mpinese/adc/bom.xlsx

Assembly | Designator | Value | Footprint | DigiKey | Quantity
Signal | C1 | 10u | Capacitor_SMD:C_1206_3216Metric | 1276-6767-1-ND | 1
Signal | C2 | 2.2u | Capacitor_SMD:C_0805_2012Metric | 1276-6655-1-ND | 1
Signal | C3, C4 | 10u | Capacitor_Tantalum_SMD:CP_EIA-3528-21_Kemet-B | 718-1926-1-ND | 2
Signal | C5, C6 | 10u | Capacitor_SMD:C_1206_3216Metric | 1276-2876-1-ND | 2
Signal | C7-C9 | 0.47u | Capacitor_SMD:C_0805_2012Metric | 1276-1039-1-ND | 3
Signal | C10, C11 | 22u | project_footprints:C_1210_3225Metric_Split | 1276-3392-1-ND | 2
Signal | C12 | 10u | project_footprints:C_1206_3216Metric_Split | 1276-3107-1-ND | 1
Signal | D1-D4 | CUS520,H3F | Diode_SMD:D_SOD-323 | CUS520H3FCT-ND | 4
Signal | R2, R3 | 330 | Resistor_SMD:R_0603_1608Metric | RG16P330BCT-ND | 2
Signal | R1, R4, R5 | 0.5 | Resistor_SMD:R_0805_2012Metric | RL12S.50FCT-ND | 3
Signal | R6, R7 | 150k | Resistor_SMD:R_0603_1608Metric | RG16P150KBCT-ND | 2
Signal | R8 | 40.2k | Resistor_SMD:R_0603_1608Metric | RG16P40.2KBCT-ND | 1
Signal | U1 | LDL1117S50R | Package_TO_SOT_SMD:SOT-223-3_TabPin2 | 497-17240-1-ND | 1
Signal | U2, U4 | LT3042xMSE | Package_SO:MSOP-10-1EP_3x3mm_P0.5mm_EP1.68x1.88mm_ThermalVias | LT3042EMSE#PBF-ND | 2
Signal | U3 | LT3093xMSE | Package_SO:MSOP-12-1EP_3x4mm_P0.65mm_EP1.65x2.85mm_ThermalVias | LT3093EMSE#PBF-ND | 1
Transformer | C1, C4 | 2200u | Capacitor_THT:CP_Radial_D10.0mm_P5.00mm | 565-3869-ND | 2
Transformer | C2, C3, C5, C6 | 2200u | Capacitor_THT:CP_Radial_D12.5mm_P5.00mm | 565-3923-ND | 4
Transformer | C7, C8 | 10u | Capacitor_THT:CP_Radial_D5.0mm_P2.00mm | 565-4993-1-ND | 2
Transformer | R1 | 10k | Resistor_THT:R_Axial_DIN0207_L6.3mm_D2.5mm_P7.62mm_Horizontal | PPC10.0KYCT-ND | 1
Transformer | R2, R3 | 3.9k | Resistor_THT:R_Axial_DIN0207_L6.3mm_D2.5mm_P7.62mm_Horizontal | 56-SFR25H0003901FR500CT-ND | 2
Transformer | R4, R5 | 330 | Resistor_THT:R_Axial_DIN0207_L6.3mm_D2.5mm_P7.62mm_Horizontal | 56-SFR25H0003300FR500CT-ND | 2
Transformer | T1 | 14A-30-515 | XFMR_14A-30-515 | 595-1828-ND | 1
Transformer | D1, D2 | D_Bridge_+-AA | Diode_THT:Diode_Bridge_DIP-4_W7.62mm_P5.08mm | DF02MDI-ND | 2
Transformer | U1 | LM317_TO-220 | Package_TO_SOT_THT:TO-220-3_Vertical | 497-19621-ND | 1
Transformer | U2 | LM337_TO220 | Package_TO_SOT_THT:TO-220-3_Vertical | LM337TGOS-ND | 1
Transformer | HS1, HS2 | Heatsink for U1,U2 |  | HS104-1-ND | 2
Case | F1, F2 | 200 mA slow blow 5x20 mm |  |  | 2
Case | J2, J3 | Conn_Coaxial |  | ARFX1905-ND | 2
Case | J4 | IEC320-C14 Power entry module |  | 1144-1003-ND | 1
Case | K1 | Knob |  | 1722-1313-ND | 1
Case | M1 | Board mounts for PCM4222EVM |  | RPC1449-ND | 4
