mpinese/adc/kicad/3d_models/CUI_DEVICES_UJ2-BH-1-TH.step

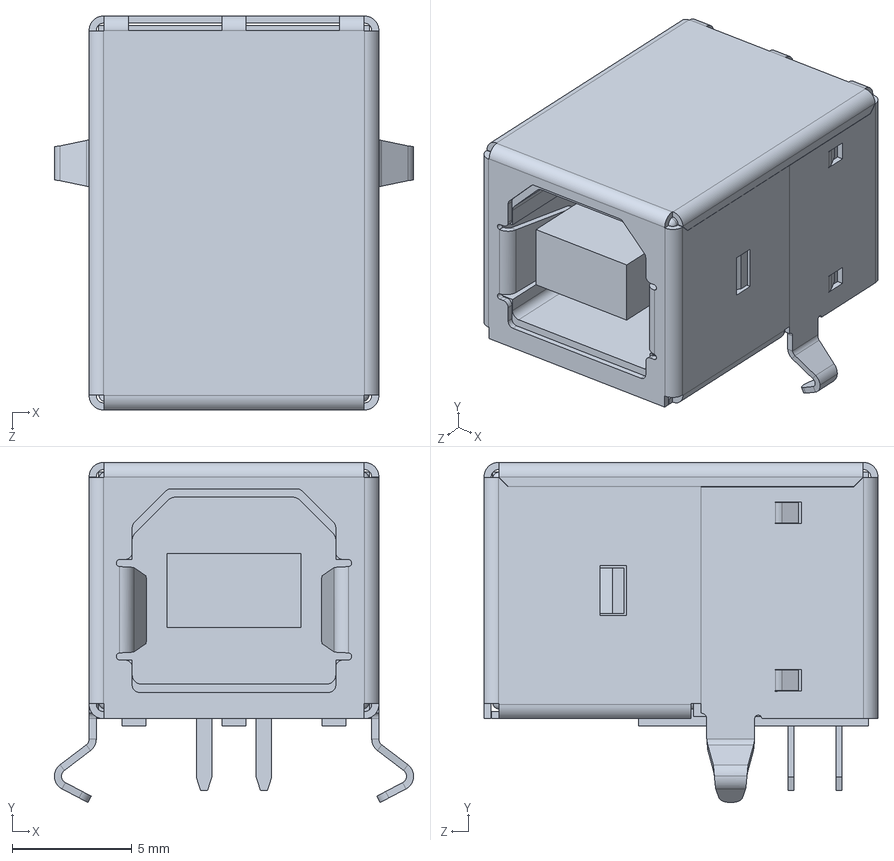
[picture p1: CAD file, 2020-09-04]
kicad/3d_models/CUI_DEVICES_UJ2-BH-1-TH.step
15.0 x 14.2 x 16.5 mm
