mpinese/adc/kicad/3d_models/14A-30-515--3DModel-STEP-1.STEP

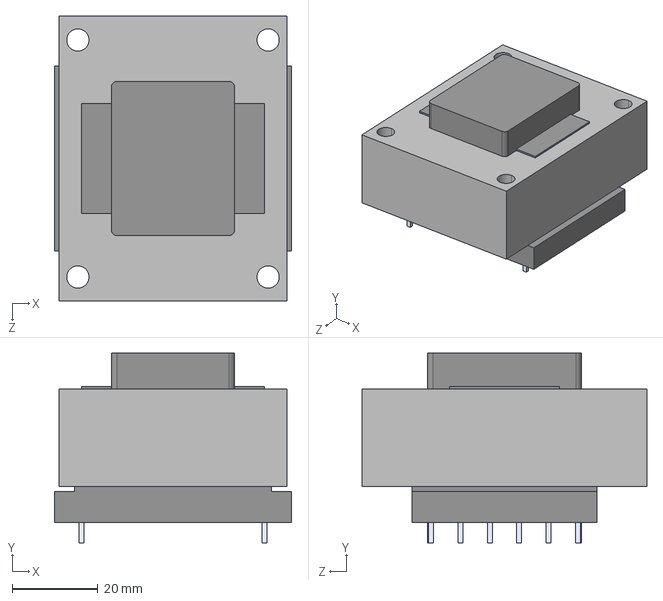
[picture p2: CAD file, 2020-09-04]
kicad/3d_models/14A-30-515--3DModel-STEP-1.STEP
55.4 x 44.4 x 66.5 mm
