mpinese/adc/kicad/usb_bridge/test_i2s_gen_cpld/test_i2s_gen.kicad_pcb

## KiCad design kicad/usb_bridge/test_i2s_gen_cpld/test_i2s_gen.kicad_pcb (2020-10-01)

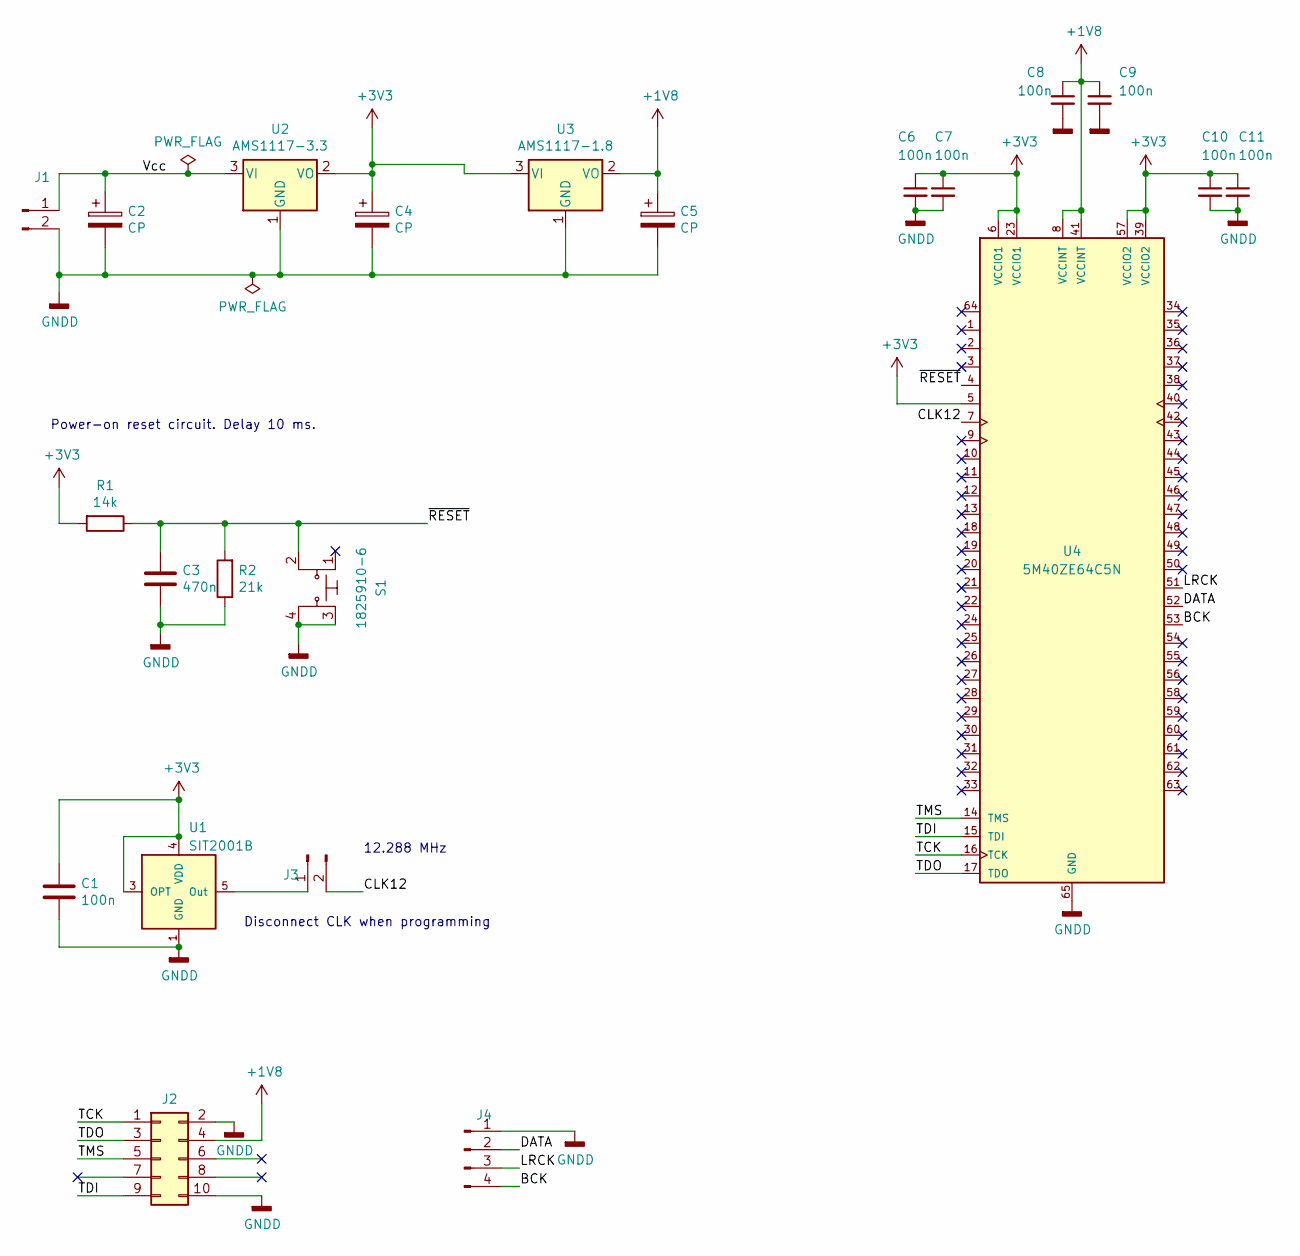
[picture p3: schematic test_i2s_gen.sch, I2S test generator]

Parts:
C1, C6, C7, C8, C9, C10, C11: 100n; C_0603_1608Metric; DigiKey 399-1099-1-ND
C2, C4, C5: CP; CP_EIA-3528-21_Kemet-B; DigiKey 478-3040-1-ND
C3: 470n; C_0603_1608Metric; DigiKey 311-1078-1-ND
J1, J3: Conn_01x02_Male; PinHeader_1x02_P2.54mm_Vertical
J2: Conn_02x05_Odd_Even; PinHeader_2x05_P2.54mm_Vertical; DigiKey ED1543-ND
J4: Conn_01x04_Male; PinHeader_1x04_P2.54mm_Vertical
R1: 14k; R_0603_1608Metric; DigiKey CR0603-FX-1402ELFCT-ND
R2: 21k; R_0603_1608Metric; DigiKey CR0603-FX-2102ELFCT-ND
S1: 1825910-6; Switch_Tactile_THT_6x6mm; DigiKey 450-1650-ND
U1: SIT2001B; SOT-23-5; DigiKey 1473-SIT2001BC-S2-33S-12.288000D-ND
U2: AMS1117-3.3; SOT-223-3_TabPin2; DigiKey AZ1117IH-3.3TRG1DICT-ND
U3: AMS1117-1.8; SOT-223-3_TabPin2; DigiKey AZ1117EH-1.8TRG1DICT-ND
U4: 5M40ZE64C5N; TQFP-64_7x7mm_P0.4mm_EP4.5x4.5mm; DigiKey 544-2717-ND

Connections:
+1V8: C5.1, C8.1, C9.1, J2.4, U3.2 (VO), U4.8 (VCCINT), U4.41 (VCCINT)
+3V3: C1.1, C4.1, C6.1, C7.1, C10.1, C11.1, R1.2, U1.3 (OPT), U1.4 (VDD), U2.2 (VO), U3.3 (VI), U4.5, U4.6 (VCCIO1), U4.23 (VCCIO1), U4.39 (VCCIO2), U4.57 (VCCIO2)
/BCK: J4.4, U4.53
/CLK12: J3.2, U4.7
/DATA: J4.2, U4.52
/LRCK: J4.3, U4.51
/TCK: J2.1, U4.16 (TCK)
/TDI: J2.9, U4.15 (TDI)
/TDO: J2.3, U4.17 (TDO)
/TMS: J2.5, U4.14 (TMS)
/Vcc: C2.1, J1.1, U2.3 (VI)
/~RESET: C3.1, R1.1, R2.2, S1.2, U4.4
GNDD: C1.2, C2.2, C3.2, C4.2, C5.2, C6.2, C7.2, C8.2, C9.2, C10.2, C11.2, J1.2, J2.2, J2.10, J4.1, R2.1, S1.3, S1.4, U1.1 (GND), U2.1 (GND), U3.1 (GND), U4.65 (GND)
unnamed: J3.1, U1.5 (Out)

Notes on the sheet:
Power-on reset circuit. Delay 10 ms.
Disconnect CLK when programming
12.288 MHz

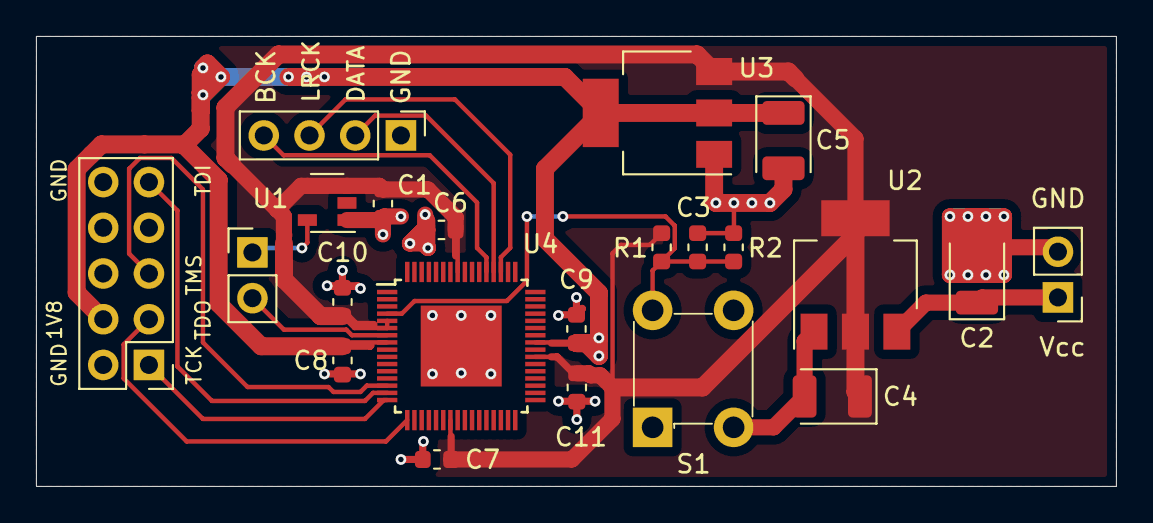
[picture p4: board kicad/usb_bridge/test_i2s_gen_cpld/test_i2s_gen.kicad_pcb from above]

Board: 2 copper layers, 60.0 x 25.0 mm, 22 parts (0 on the bottom side), 14 nets.
