mpinese/adc/kicad/usb_bridge/test_i2s_gen_discrete/test_i2s_gen.kicad_pcb

## KiCad design kicad/usb_bridge/test_i2s_gen_discrete/test_i2s_gen.kicad_pcb (2020-10-01)

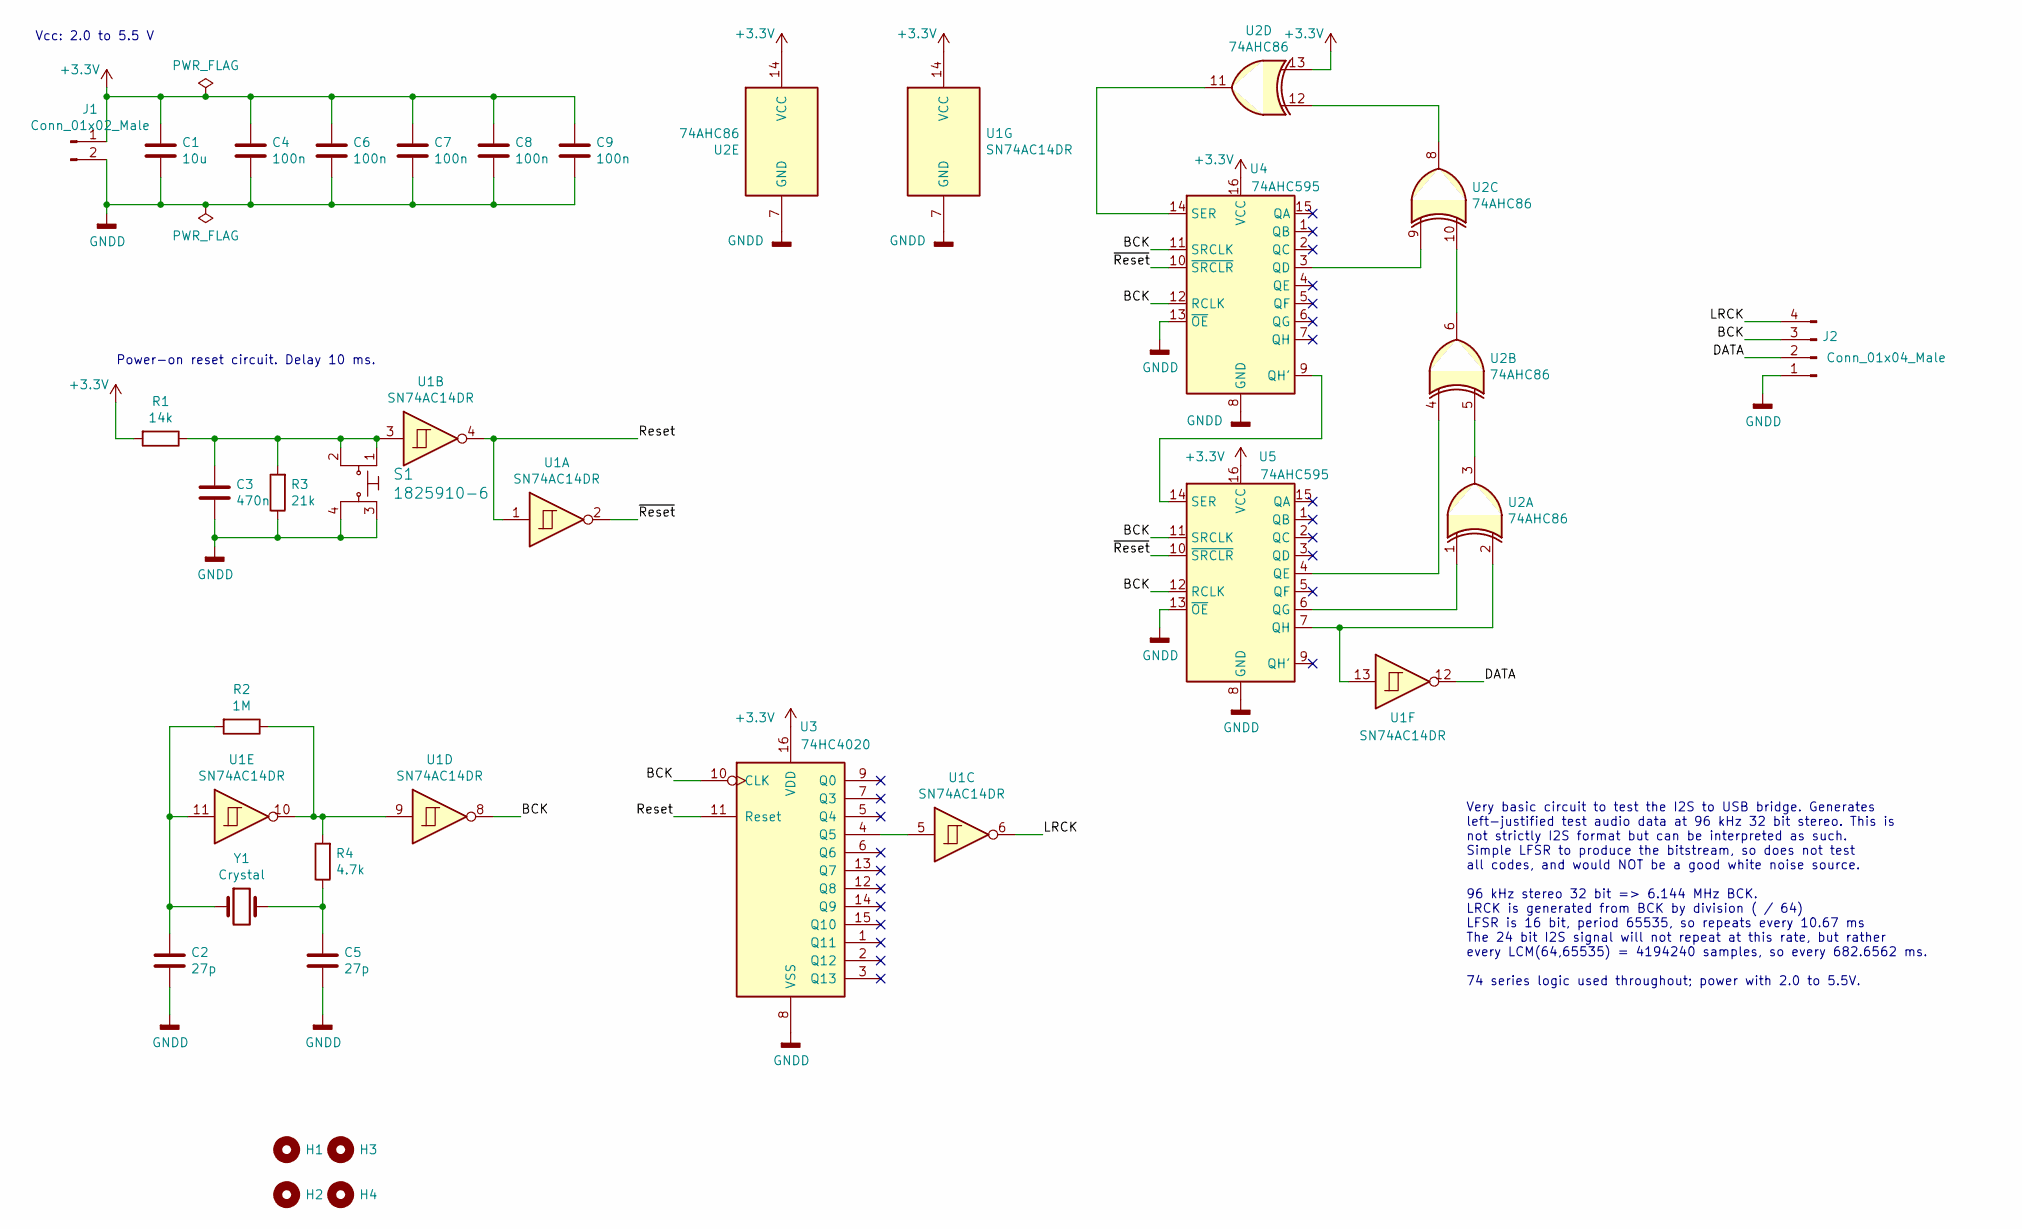
[picture p5: schematic test_i2s_gen.sch, I2S test generator]

Parts:
C1: 10u; C_0805_2012Metric; DigiKey 1276-1764-1-ND
C2, C5: 27p; C_0603_1608Metric; DigiKey 311-3929-1-ND
C3: 470n; C_0603_1608Metric; DigiKey 311-1078-1-ND
C4, C6, C7, C8, C9: 100n; C_0603_1608Metric; DigiKey 399-1099-1-ND
H1, H2, H3, H4: MountingHole; MountingHole_2.2mm_M2
J1: Conn_01x02_Male; PinHeader_1x02_P2.54mm_Vertical
J2: Conn_01x04_Male; PinHeader_1x04_P2.54mm_Vertical
R1: 14k; R_0603_1608Metric; DigiKey CR0603-FX-1402ELFCT-ND
R2: 1M; R_0603_1608Metric; DigiKey CR0603-JW-105ELFCT-ND
R3: 21k; R_0603_1608Metric; DigiKey CR0603-FX-2102ELFCT-ND
R4: 4.7k; R_0603_1608Metric; DigiKey CR0603-JW-472ELFCT-ND
S1: 1825910-6; Switch_Tactile_THT_6x6mm; DigiKey 450-1650-ND
U1: SN74AC14DR; SOIC-14_3.9x8.7mm_P1.27mm; DigiKey 296-4300-1-ND
U2: 74AHC86; SOIC-14_3.9x8.7mm_P1.27mm; DigiKey 296-4625-5-ND
U3: 74HC4020; SOIC-16_3.9x9.9mm_P1.27mm; DigiKey MC74HC4020ADR2GOSCT-ND
U4, U5: 74AHC595; SOIC-16_3.9x9.9mm_P1.27mm; DigiKey 1727-5926-1-ND
Y1: Crystal; Crystal_SMD_HC49-SD; DigiKey XC2780CT-ND

Connections:
+3V3: C1.1, C4.1, C6.1, C7.1, C8.1, C9.1, J1.1, R1.2, U1.14 (VCC), U2.13, U2.14 (VCC), U3.16 (VDD), U4.16 (VCC), U5.16 (VCC)
/BCK: J2.3, U1.8, U3.10 (CLK), U4.11 (SRCLK), U4.12 (RCLK), U5.11 (SRCLK), U5.12 (RCLK)
/DATA: J2.2, U1.12
/LRCK: J2.4, U1.6
/Reset: U1.1, U1.4, U3.11 (Reset)
/~Reset: U1.2, U4.10 (~SRCLR), U5.10 (~SRCLR)
GNDD: C1.2, C2.2, C3.2, C4.2, C5.2, C6.2, C7.2, C8.2, C9.2, J1.2, J2.1, R3.1, S1.3, S1.4, U1.7 (GND), U2.7 (GND), U3.8 (VSS), U4.8 (GND), U4.13 (~OE), U5.8 (GND), U5.13 (~OE)
unnamed: C2.1, R2.2, U1.11, Y1.1
unnamed: C3.1, R1.1, R3.2, S1.1, S1.2, U1.3
unnamed: C5.1, R4.1, Y1.2
unnamed: R2.1, R4.2, U1.9, U1.10
unnamed: U1.5, U3.4 (Q5)
unnamed: U1.13, U2.2, U5.7 (QH)
unnamed: U2.1, U5.6 (QG)
unnamed: U2.3, U2.5
unnamed: U2.4, U5.4 (QE)
unnamed: U2.9, U4.3 (QD)
unnamed: U2.6, U2.10
unnamed: U2.11, U4.14 (SER)
unnamed: U2.8, U2.12
unnamed: U4.9 (QH'), U5.14 (SER)

Notes on the sheet:
Very basic circuit to test the I2S to USB bridge. Generates left-justified test audio data at 96 kHz 32 bit stereo. This is not strictly I2S format but can be interpreted as such. Simple LFSR to produce the bitstream, so does not test all codes, and would NOT be a good white noise source. 96 kHz st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
Power-on reset circuit. Delay 10 ms.
Vcc: 2.0 to 5.5 V

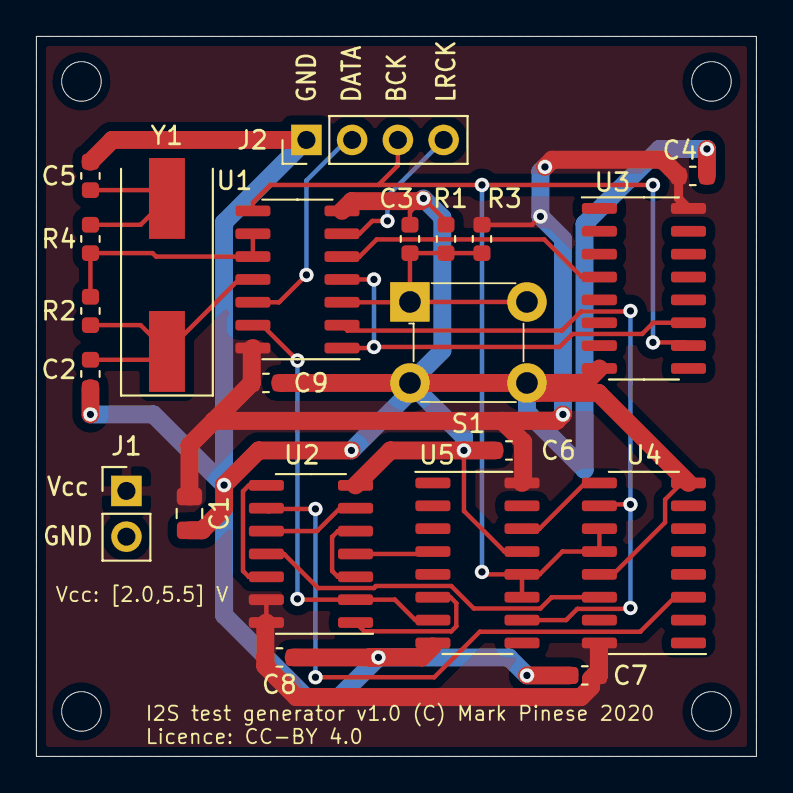
[picture p6: board kicad/usb_bridge/test_i2s_gen_discrete/test_i2s_gen.kicad_pcb from above]

Board: 2 copper layers, 40.0 x 40.0 mm, 26 parts (0 on the bottom side), 21 nets.
