mpinese/adc/kicad/transformer_board/transformer_board.kicad_pcb

## KiCad design kicad/transformer_board/transformer_board.kicad_pcb (2020-09-29)

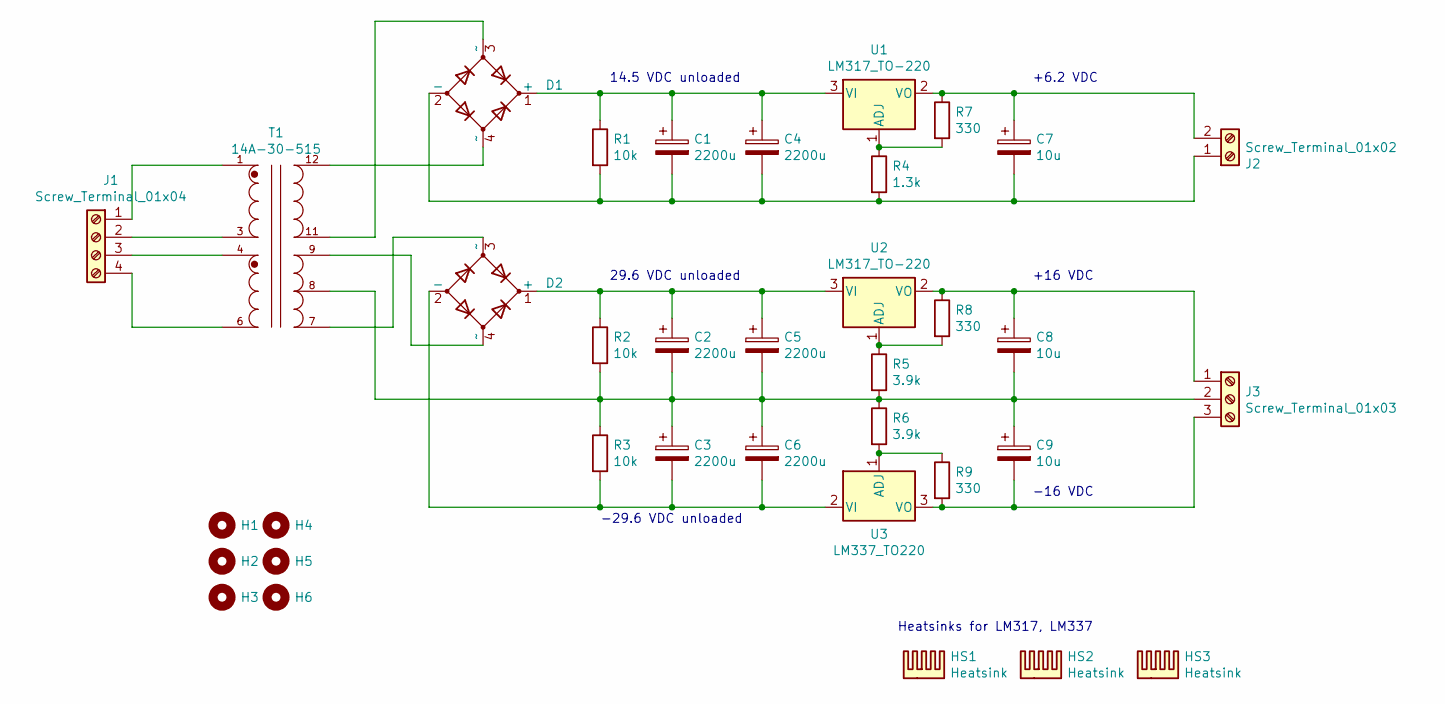
[picture p7: schematic transformer_board.sch, PCM4222EVM transformer board]

Parts:
C1, C4: 2200u; CP_Radial_D10.0mm_P5.00mm; DigiKey 565-3869-ND
C2, C3, C5, C6: 2200u; CP_Radial_D12.5mm_P5.00mm; DigiKey 565-3923-ND
C7, C8, C9: 10u; CP_Radial_D5.0mm_P2.00mm; DigiKey 732-9501-1-ND
D1, D2: D_Bridge_+-AA; Diode_Bridge_DIP-4_W7.62mm_P5.08mm; DigiKey DF02MDI-ND
H1, H2, H3, H4, H5, H6: MountingHole; MountingHole_3.2mm_M3
HS1, HS2, HS3: Heatsink; AAVID_504102B00000G; DigiKey HS104-1-ND
J1: Screw_Terminal_01x04; TerminalBlock_Phoenix_PT-1,5-4-5.0-H_1x04_P5.00mm_Horizontal; DigiKey 277-1579-ND
J2: Screw_Terminal_01x02; TerminalBlock_Phoenix_PT-1,5-2-5.0-H_1x02_P5.00mm_Horizontal; DigiKey 277-1667-ND
J3: Screw_Terminal_01x03; TerminalBlock_Phoenix_PT-1,5-3-5.0-H_1x03_P5.00mm_Horizontal; DigiKey 277-1578-ND
R1, R2, R3: 10k; R_Axial_DIN0207_L6.3mm_D2.5mm_P7.62mm_Horizontal; DigiKey PPC10.0KYCT-ND
R4: 1.3k; R_Axial_DIN0207_L6.3mm_D2.5mm_P7.62mm_Horizontal; DigiKey PPC1.30KYCT-ND
R5, R6: 3.9k; R_Axial_DIN0207_L6.3mm_D2.5mm_P7.62mm_Horizontal; DigiKey 56-SFR2500003901FR500CT-ND
R7, R9: 330; R_Axial_DIN0207_L6.3mm_D2.5mm_P7.62mm_Horizontal; DigiKey BC4366CT-ND
R8: 330; R_Axial_DIN0207_L6.3mm_D2.5mm_P7.62mm_Horizontal; DigiKey 56-SFR25H0003300FR500CT-ND
T1: 14A-30-515; XFMR_14A-30-515; DigiKey 595-1828-ND
U1, U2: LM317_TO-220; TO-220-3_Horizontal_TabDown; DigiKey 497-19621-ND
U3: LM337_TO220; TO-220-3_Horizontal_TabDown; DigiKey LM337TGOS-ND

Connections:
unnamed: C1.1, C4.1, D1.1 (+), R1.1, U1.3 (VI)
unnamed: C1.2, C4.2, C7.2, D1.2 (-), J2.1, R1.2, R4.2
unnamed: C2.1, C5.1, D2.1 (+), R2.1, U2.3 (VI)
unnamed: C2.2, C3.1, C5.2, C6.1, C8.2, C9.1, J3.2, R2.2, R3.1, R5.2, R6.1, T1.8
unnamed: C3.2, C6.2, D2.2 (-), R3.2, U3.2 (VI)
unnamed: C7.1, J2.2, R7.1, U1.2 (VO)
unnamed: C8.1, J3.1, R8.1, U2.2 (VO)
unnamed: C9.2, J3.3, R9.2, U3.3 (VO)
unnamed: D1.3 (~~), T1.11
unnamed: D1.4 (~~), T1.12
unnamed: D2.3 (~~), T1.7
unnamed: D2.4 (~~), T1.9
unnamed: J1.1, T1.1
unnamed: J1.2, T1.3
unnamed: J1.3, T1.4
unnamed: J1.4, T1.6
unnamed: R4.1, R7.2, U1.1 (ADJ)
unnamed: R5.1, R8.2, U2.1 (ADJ)
unnamed: R6.2, R9.1, U3.1 (ADJ)

Notes on the sheet:
14.5 VDC unloaded
29.6 VDC unloaded
-29.6 VDC unloaded
+16 VDC
-16 VDC
Heatsinks for LM317, LM337
+6.2 VDC

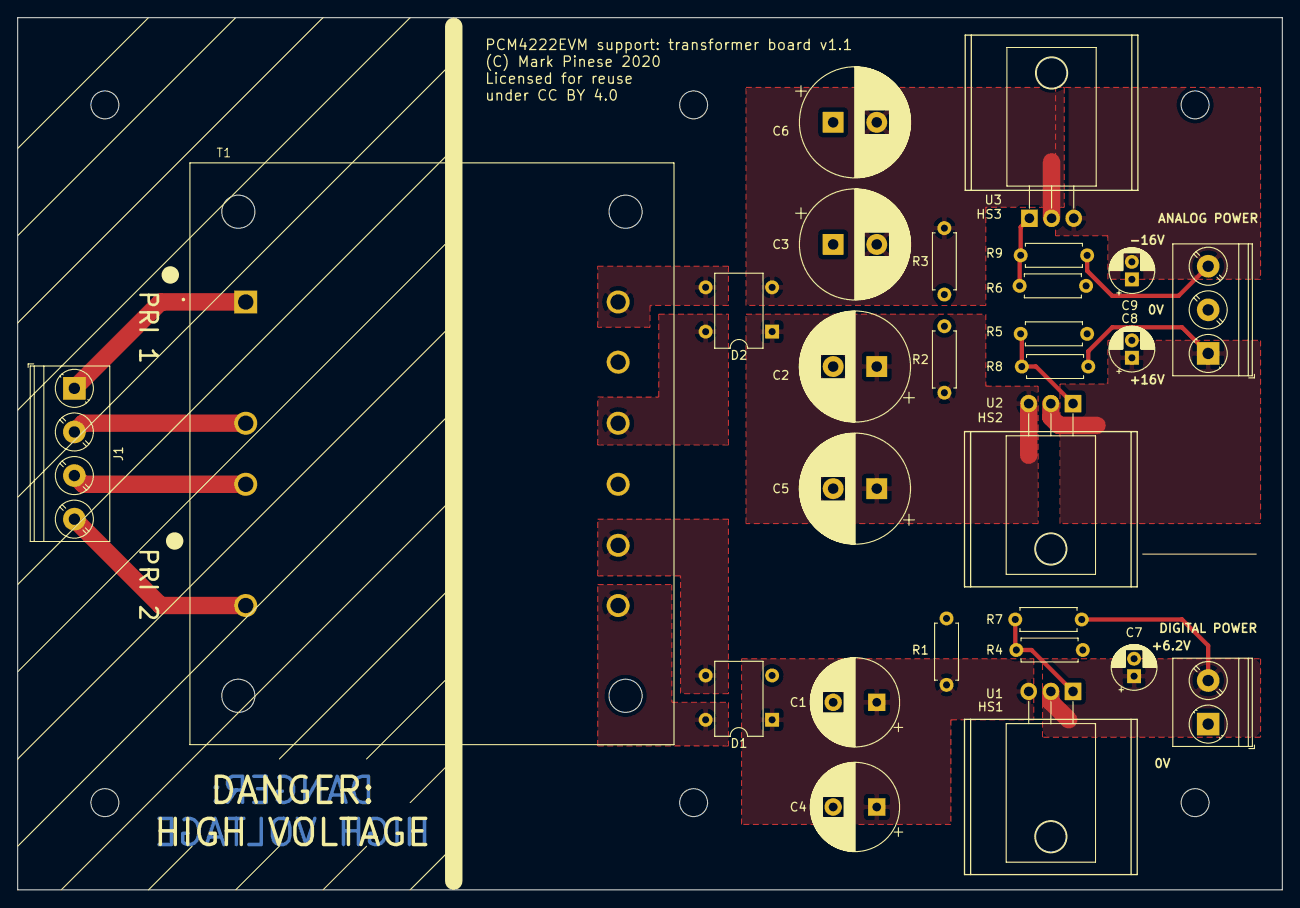
[picture p8: board transformer_board.kicad_pcb from above]

Board: 2 copper layers, 145.0 x 100.0 mm, 36 parts (0 on the bottom side), 19 nets.
