mpinese/adc/kicad/usb_bridge/usb_bridge.kicad_pcb

## KiCad design kicad/usb_bridge/usb_bridge.kicad_pcb (2020-09-11)

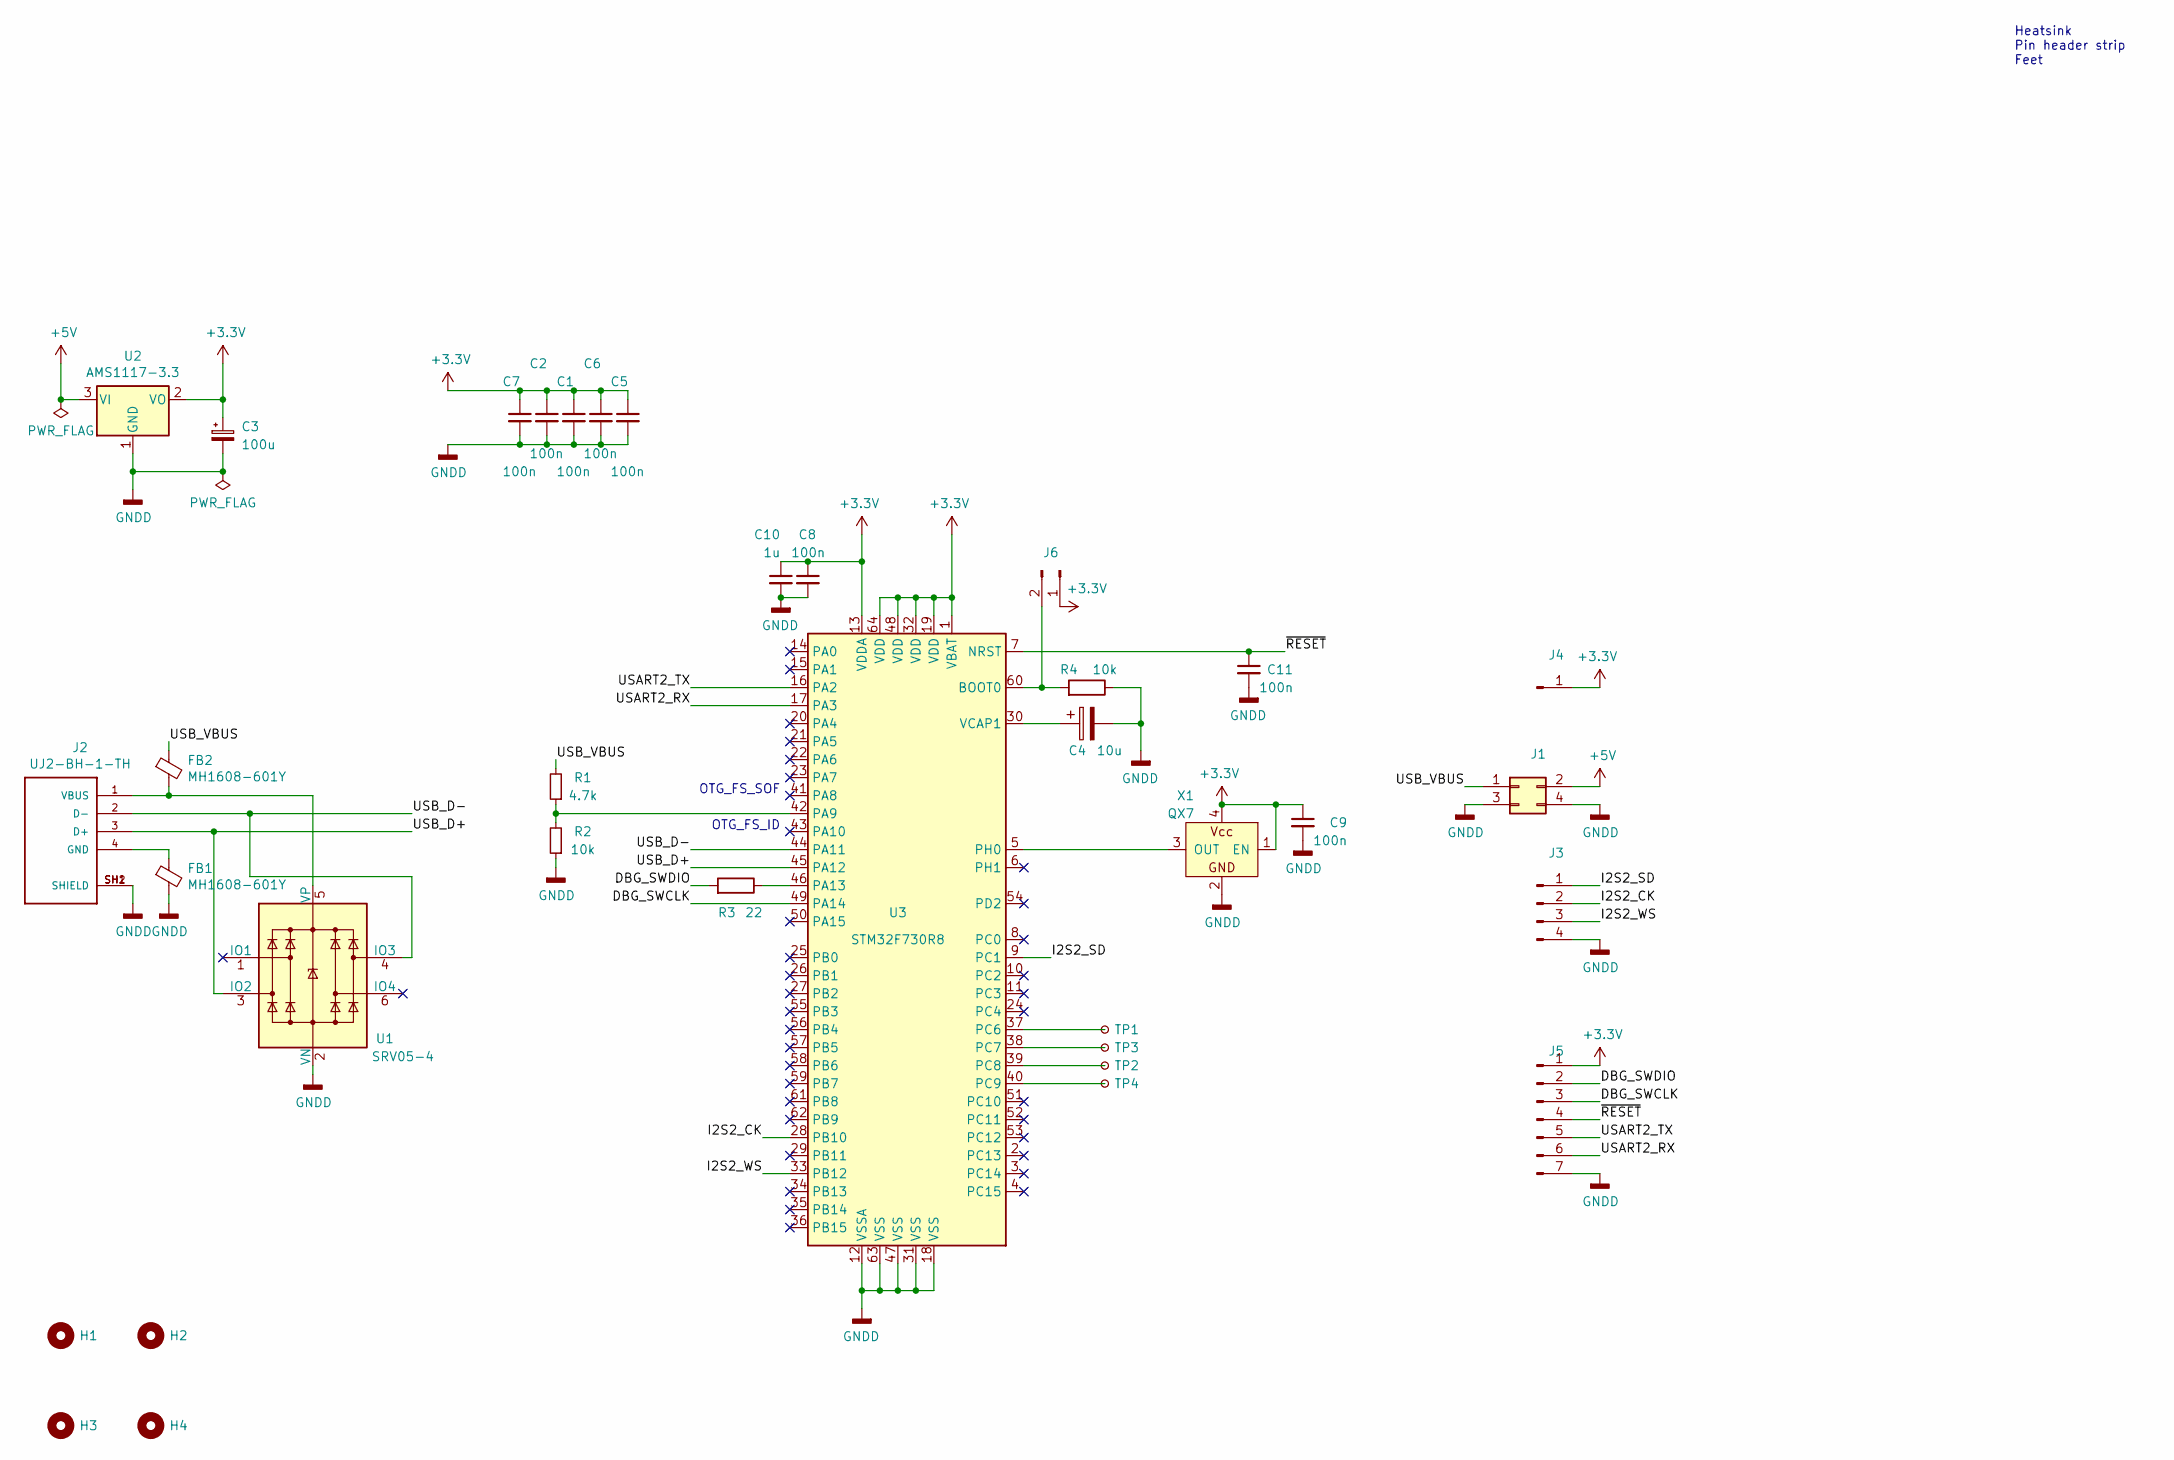
[picture p9: schematic usb_bridge.sch]

Parts:
C1, C2, C5, C6, C7, C8, C9, C11: 100n; C_0402_1005Metric; LCSC C1525
C3: 100u; CP_EIA-3528-21_Kemet-B; LCSC C16133
C4: 10u; CP_EIA-2012-15_AVX-P_Pad1.30x1.05mm_HandSolder; DigiKey 718-2064-1-ND
C10: 1u; C_0402_1005Metric; LCSC C52923
FB1, FB2: MH1608-601Y; L_0603_1608Metric; DigiKey MH1608-601YCT-ND
H1, H2, H3, H4: MountingHole; MountingHole_3.2mm_M3
J1: Conn_01x02_Male; PinHeader_2x02_P2.54mm_Vertical
J2: UJ2-BH-1-TH; CUI_UJ2-BH-1-TH; DigiKey 102-3999-ND
J3: Conn_01x04_Male; PinHeader_1x04_P2.54mm_Vertical
J4: Conn_01x01_Male; PinHeader_1x01_P2.54mm_Vertical
J5: Conn_01x07_Male; PinHeader_1x07_P2.54mm_Vertical
J6: Conn_01x02_Male; PinHeader_1x02_P2.54mm_Vertical
R1: 4.7k; R_0402_1005Metric; LCSC C25900
R2, R4: 10k; R_0402_1005Metric; LCSC C25744
R3: 22; R_0402_1005Metric; LCSC C25092
TP1, TP2, TP3, TP4: TestPoint_Small; TestPoint_Pad_D1.0mm
U1: SRV05-4; SOT-23-6; LCSC C85364
U2: AMS1117-3.3; SOT-223-3_TabPin2; LCSC C6186
U3: STM32F730R8; LQFP-64_10x10mm_P0.5mm; DigiKey 497-18103-ND
X1: QX7; QTX333

Connections:
+3V3: C1.1, C2.1, C3.1, C5.1, C6.1, C7.1, C8.1, C9.1, C10.1, J4.1, J5.1, J6.1, U2.2 (VO), U3.1 (VBAT), U3.13 (VDDA), U3.19 (VDD), U3.32 (VDD), U3.48 (VDD), U3.64 (VDD), X1.1 (EN), X1.4
+5V: J1.2, U2.3 (VI)
/DBG_SWCLK: J5.3, U3.49 (PA14)
/DBG_SWDIO: J5.2, R3.2
/I2S2_CK: J3.2, U3.28 (PB10)
/I2S2_SD: J3.1, U3.9 (PC1)
/I2S2_WS: J3.3, U3.33 (PB12)
/USART2_RX: J5.6, U3.17 (PA3)
/USART2_TX: J5.5, U3.16 (PA2)
/USB_D+: J2.3 (D+), U1.3 (IO2), U3.45 (PA12)
/USB_D-: J2.2 (D-), U1.4 (IO3), U3.44 (PA11)
/USB_VBUS: FB2.1, J1.1, R1.2
/~RESET: C11.1, J5.4, U3.7 (NRST)
GNDD: C1.2, C2.2, C3.2, C4.2, C5.2, C6.2, C7.2, C8.2, C9.2, C10.2, C11.2, FB1.2, J1.3, J1.4, J2.SH1 (SHIELD), J2.SH2 (SHIELD), J3.4, J5.7, R2.1, R4.1, U1.2 (VN), U2.1 (GND), U3.12 (VSSA), U3.18 (VSS), U3.31 (VSS), U3.47 (VSS), U3.63 (VSS), X1.2
unnamed: C4.1, U3.30 (VCAP1)
unnamed: FB1.1, J2.4 (GND)
unnamed: FB2.2, J2.1 (VBUS), U1.5 (VP)
unnamed: J6.2, R4.2, U3.60 (BOOT0)
unnamed: R1.1, R2.2, U3.42 (PA9)
unnamed: R3.1, U3.46 (PA13)
unnamed: TP1.1, U3.37 (PC6)
unnamed: TP2.1, U3.39 (PC8)
unnamed: TP3.1, U3.38 (PC7)
unnamed: TP4.1, U3.40 (PC9)
unnamed: U3.5 (PH0), X1.3 (OUT)

Notes on the sheet:
Heatsink Pin header strip Feet
OTG_FS_SOF
OTG_FS_ID

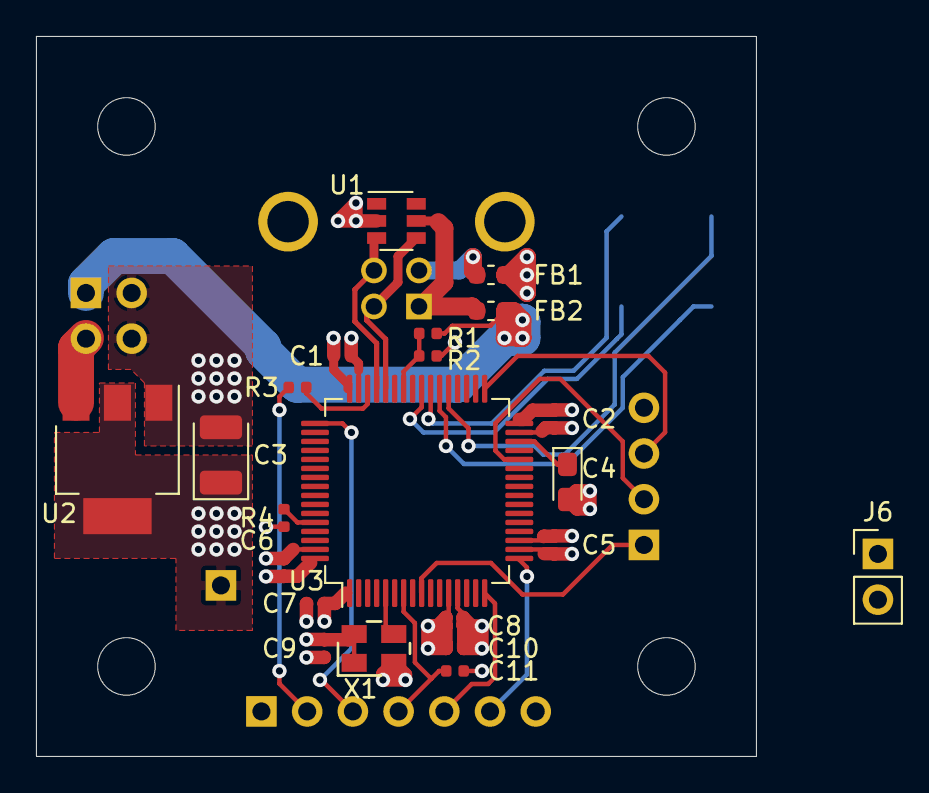
[picture p10: board usb_bridge.kicad_pcb from above]

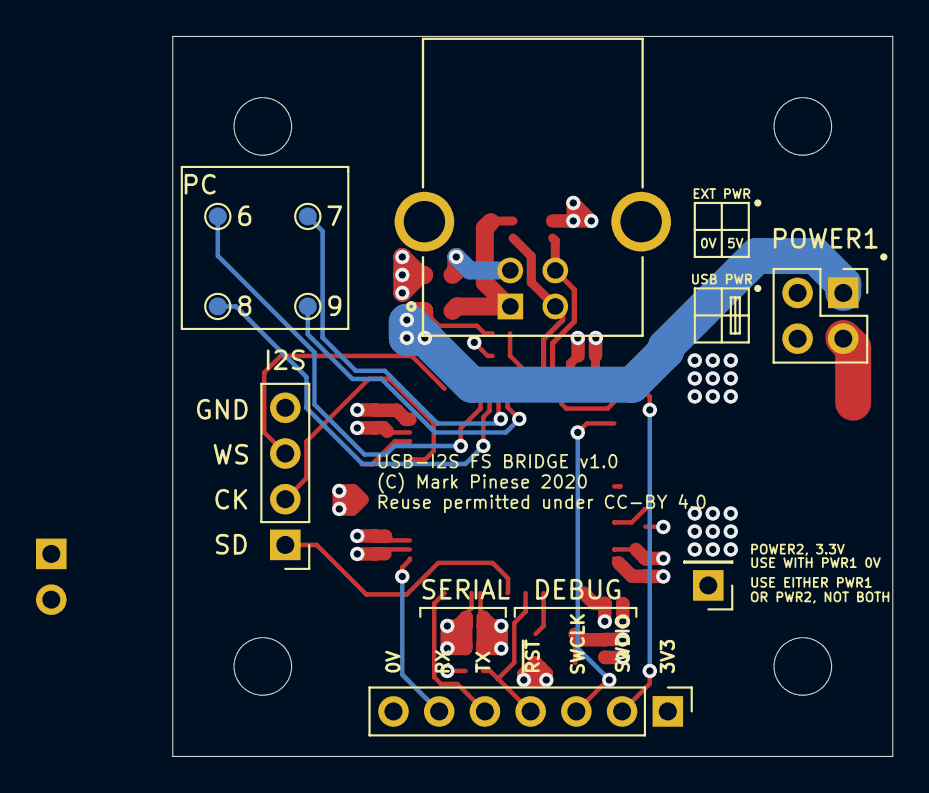
[picture p11: board usb_bridge.kicad_pcb from below]

Board: 4 copper layers, 40.0 x 40.0 mm, 35 parts (9 on the bottom side), 25 nets.
