mpinese/adc/kicad/signal_board/signal_board.kicad_pcb

## KiCad design kicad/signal_board/signal_board.kicad_pcb (2020-09-04)

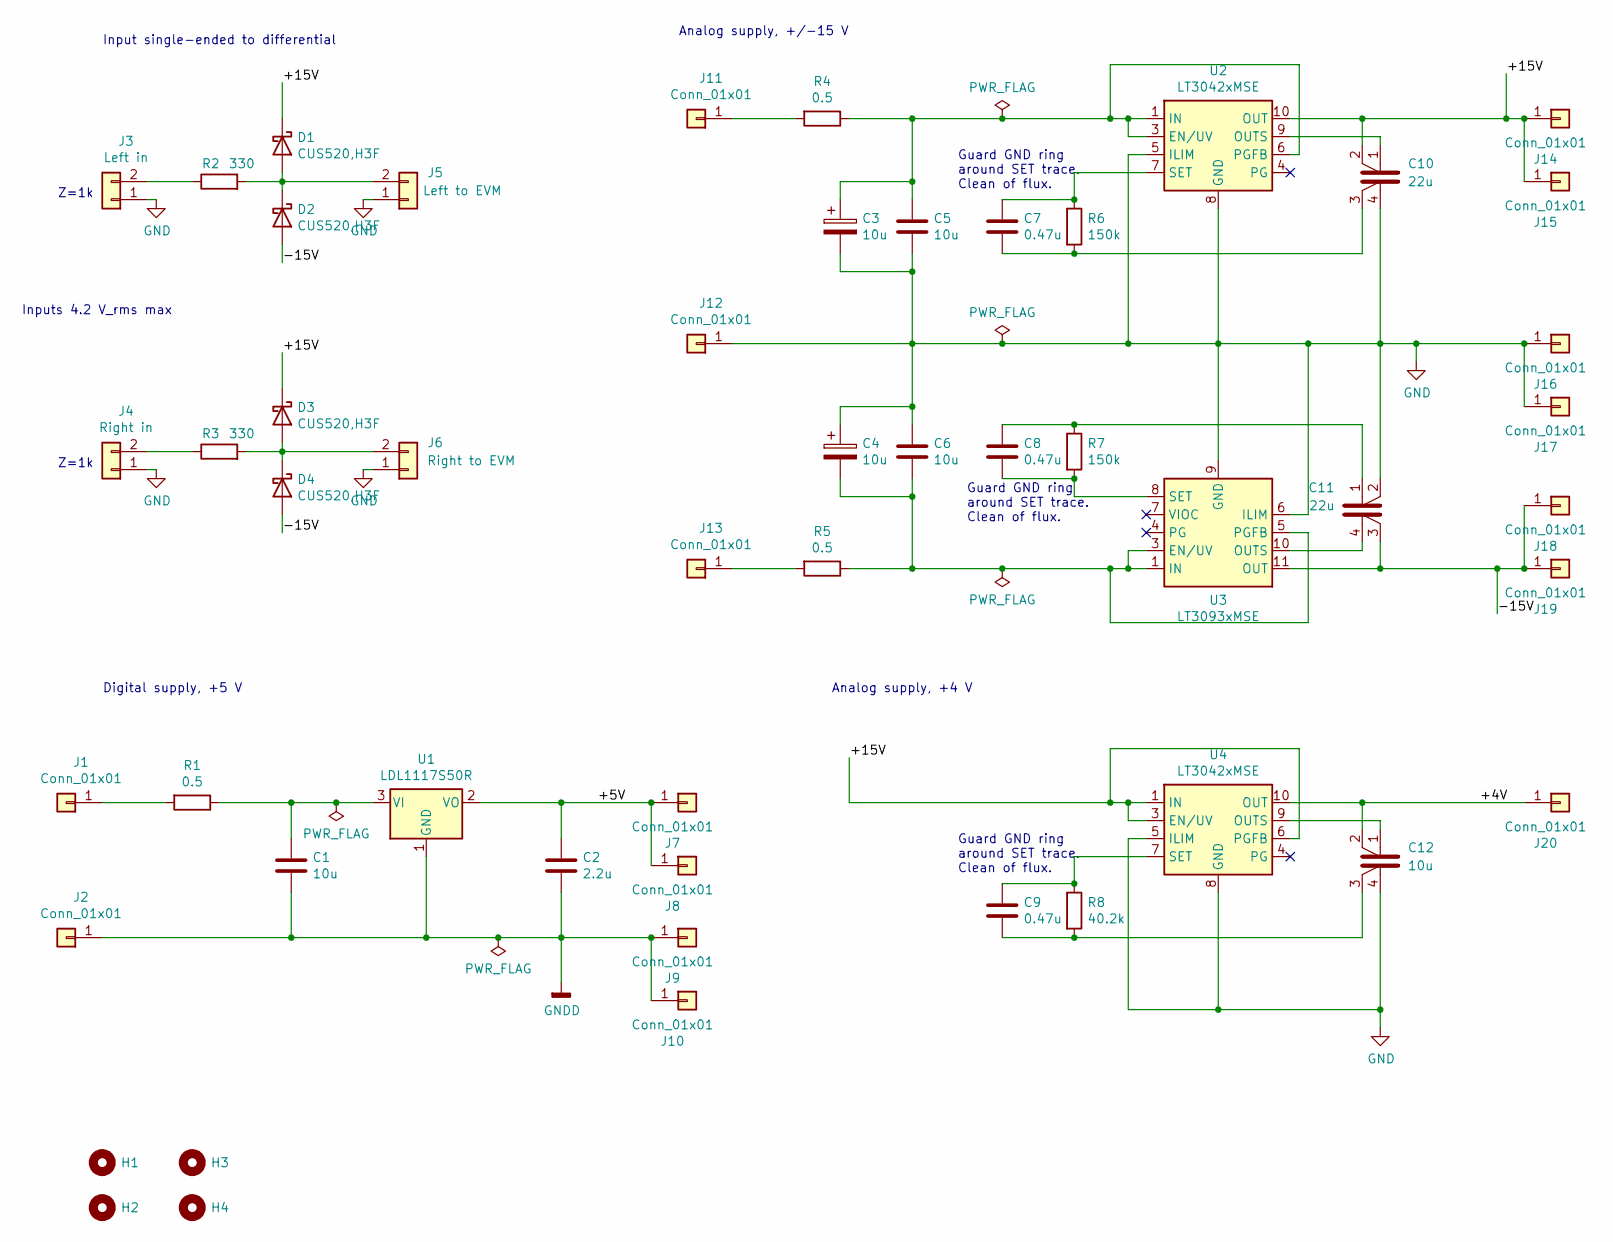
[picture p12: schematic signal_board.sch, PCM4222EVM PSU and signal board]

Parts:
C1: 10u; C_1206_3216Metric; DigiKey 1276-6767-1-ND
C2: 2.2u; C_0805_2012Metric; DigiKey 1276-6655-1-ND
C3, C4: 10u; CP_EIA-3528-21_Kemet-B; DigiKey 718-1926-1-ND
C5, C6: 10u; C_1206_3216Metric; LCSC C13585
C7, C8, C9: 0.47u; C_0805_2012Metric; LCSC C13967
C10, C11: 22u; C_1210_3225Metric_Split; DigiKey 1276-3392-1-ND
C12: 10u; C_1206_3216Metric_Split; DigiKey 1276-3107-1-ND
D1, D2, D3, D4: CUS520,H3F; D_SOD-323; DigiKey CUS520H3FCT-ND
H1, H2, H3, H4: MountingHole; MountingHole_3.2mm_M3
J1, J2, J7, J8, J9, J10, J11, J12, J13, J14, J15, J16, J17, J18, J19, J20: Conn_01x01; SolderWirePad_1x01_Drill1mm
J3: Left in; PinHeader_1x02_P2.54mm_Vertical
J4: Right in; PinHeader_1x02_P2.54mm_Vertical
J5: Left to EVM; PinHeader_1x02_P2.54mm_Vertical
J6: Right to EVM; PinHeader_1x02_P2.54mm_Vertical
R1, R4, R5: 0.5; R_0805_2012Metric; DigiKey RL12S.50FCT-ND
R2, R3: 330; R_0603_1608Metric; DigiKey RG16P330BCT-ND
R6, R7: 150k; R_0603_1608Metric; DigiKey RG16P150KBCT-ND
R8: 40.2k; R_0603_1608Metric; DigiKey RG16P40.2KBCT-ND
U1: LDL1117S50R; SOT-223-3_TabPin2; DigiKey 497-17240-1-ND
U2, U4: LT3042xMSE; MSOP-10-1EP_3x3mm_P0.5mm_EP1.68x1.88mm_ThermalVias; DigiKey LT3042EMSE#PBF-ND
U3: LT3093xMSE; MSOP-12-1EP_3x4mm_P0.65mm_EP1.65x2.85mm_ThermalVias; DigiKey LT3093EMSE#PBF-ND

Connections:
/+4V: C12.2, J20.1, U4.10 (OUT)
/+5V: C2.1, J7.1, J8.1, U1.2 (VO)
/+15V: C10.2, D1.1 (K), D3.1 (K), J14.1, J15.1, U2.10 (OUT), U4.1 (IN), U4.2 (IN), U4.3 (EN/UV), U4.6 (PGFB)
/-15V: C11.3, D2.2 (A), D4.2 (A), J18.1, J19.1, U3.11 (OUT), U3.12 (OUT)
GND: C3.2, C4.1, C5.2, C6.1, C10.4, C11.2, C12.4, J3.1, J4.1, J5.1, J6.1, J12.1, J16.1, J17.1, U2.5 (ILIM), U2.8 (GND), U2.11 (GND), U3.6 (ILIM), U3.9 (GND), U4.5 (ILIM), U4.8 (GND), U4.11 (GND)
GNDD: C1.2, C2.2, J2.1, J9.1, J10.1, U1.1 (GND)
unnamed: C1.1, R1.1, U1.3 (VI)
unnamed: C3.1, C5.1, R4.1, U2.1 (IN), U2.2 (IN), U2.3 (EN/UV), U2.6 (PGFB)
unnamed: C4.2, C6.2, R5.1, U3.1 (IN), U3.2 (IN), U3.3 (EN/UV), U3.5 (PGFB), U3.13 (IN)
unnamed: C7.1, R6.1, U2.7 (SET)
unnamed: C8.2, R7.2, U3.8 (SET)
unnamed: C9.1, R8.1, U4.7 (SET)
unnamed: C10.1, U2.9 (OUTS)
unnamed: C7.2, C10.3, R6.2
unnamed: C8.1, C11.1, R7.1
unnamed: C11.4, U3.10 (OUTS)
unnamed: C12.1, U4.9 (OUTS)
unnamed: C9.2, C12.3, R8.2
unnamed: D1.2 (A), D2.1 (K), J5.2, R2.2
unnamed: D3.2 (A), D4.1 (K), J6.2, R3.2
unnamed: J1.1, R1.2
unnamed: J3.2, R2.1
unnamed: J4.2, R3.1
unnamed: J11.1, R4.2
unnamed: J13.1, R5.2

Notes on the sheet:
Guard GND ring around SET trace. Clean of flux.
Z=1k
Input single-ended to differential
Digital supply, +5 V
Analog supply, +/-15 V
Analog supply, +4 V
Inputs 4.2 V_rms max

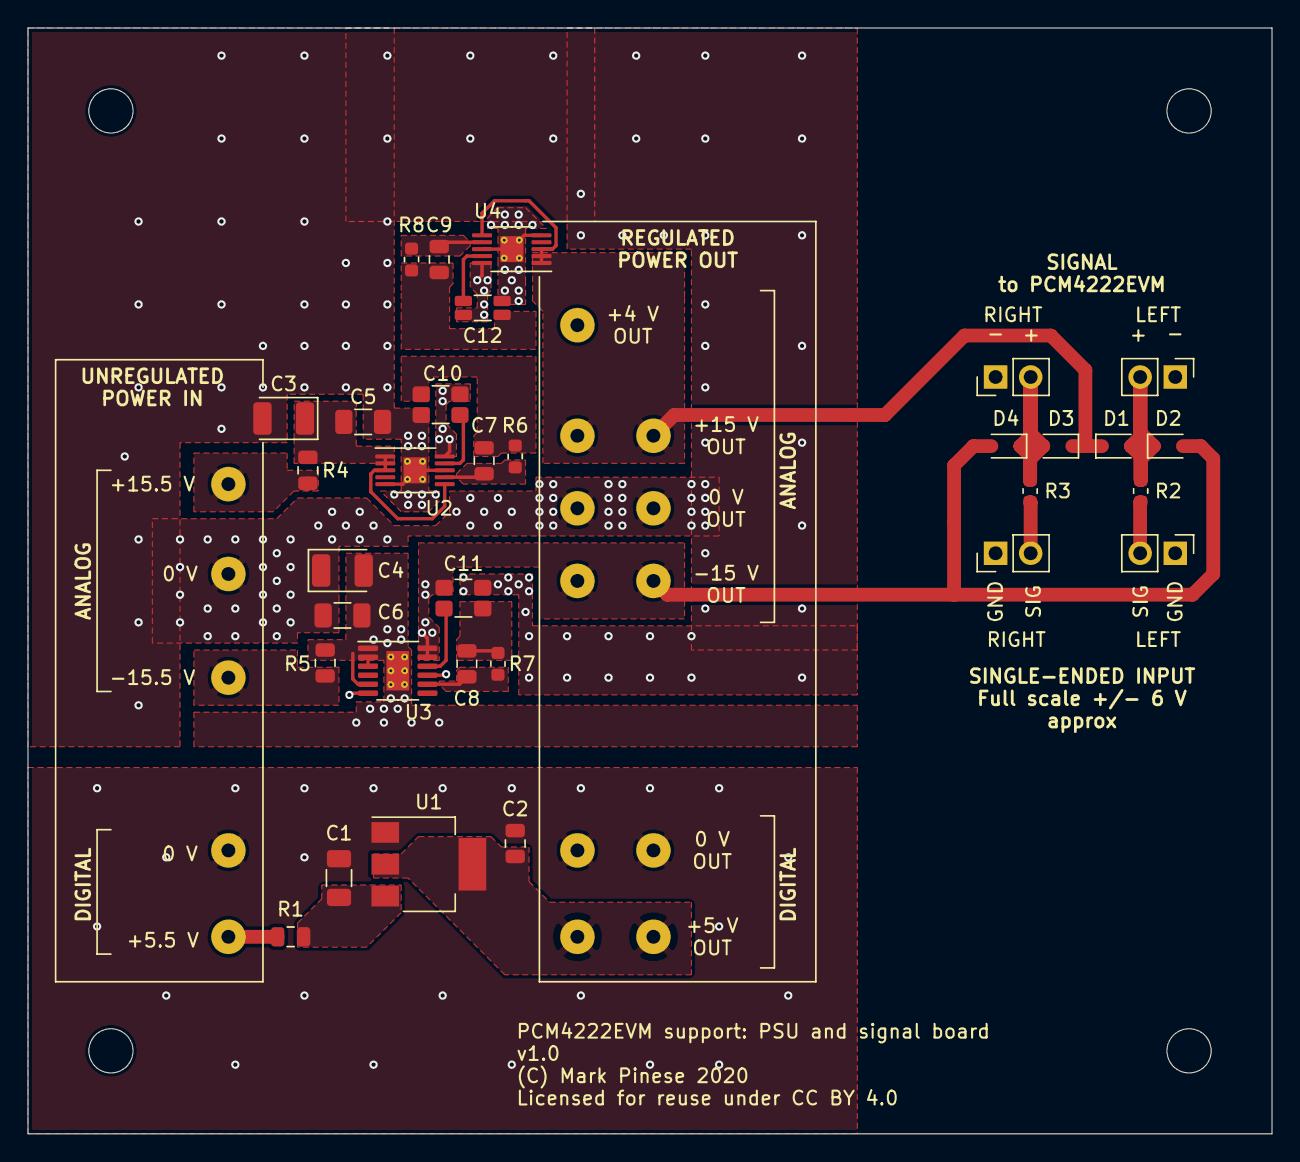
[picture p13: board signal_board.kicad_pcb from above]

Board: 2 copper layers, 90.0 x 80.0 mm, 52 parts (0 on the bottom side), 25 nets.
