mpinese/adc/firmware/I2S to USB FS bridge/Core/Src/main.c

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
/* Includes ------------------------------------------------------------------*/
#include "main.h"

/* USER CODE BEGIN Includes */
#include "i2s_to_usb_controller.h"
#include "usbd_core.h"
#include "usbd_desc.h"
#include "usbd_i2s_to_usb.h"

#include "debug_funcs.h"
/* USER CODE END Includes */


I2S_HandleTypeDef hi2s2;
DMA_HandleTypeDef hdma_spi2_rx;

UART_HandleTypeDef huart2;

PCD_HandleTypeDef hpcd_USB_OTG_FS;

/* USER CODE BEGIN PV */
USBD_HandleTypeDef hUsbDeviceFS;
/* USER CODE END PV */

void SystemClock_Config(void);
static void MX_GPIO_Init(void);
static void MX_DMA_Init(void);
static void MX_I2S2_Init(void);
static void MX_USART2_UART_Init(void);
static void MX_USB_OTG_FS_PCD_Init(void);
/**
  * @brief  The application entry point.
  * @retval int
  */
int main(void)
{
  /* MCU Configuration--------------------------------------------------------*/

  /* Reset of all peripherals, Initializes the Flash interface and the Systick. */
  HAL_Init();

  /* USER CODE BEGIN Init */
	controller_reset();
  /* USER CODE END Init */

  /* Configure the system clock */
  SystemClock_Config();

  /* Initialize all configured peripherals */
  MX_GPIO_Init();
  MX_DMA_Init();
  MX_I2S2_Init();
  MX_USART2_UART_Init();
  MX_USB_OTG_FS_PCD_Init();
  /* USER CODE BEGIN 2 */
	USBD_Init(&hUsbDeviceFS, &I2S_to_USB_Desc, 0);
	USBD_RegisterClass(&hUsbDeviceFS, &USBD_I2S_to_USB_ClassDriver);
	USBD_Start(&hUsbDeviceFS);
  /* USER CODE END 2 */

  /* Infinite loop */
  /* USER CODE BEGIN WHILE */
	while (1)
	{
    /* USER CODE END WHILE */

    /* USER CODE BEGIN 3 */
	controller_attempt_upload();
	}
  /* USER CODE END 3 */
}

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
