mpinese/adc/firmware/I2S to USB FS bridge/I2S to USB FS bridge.ioc

Mcu.UserName=STM32F730R8Tx
PA11.Signal=USB_OTG_FS_DM
PA12.Signal=USB_OTG_FS_DP
PA13.Signal=SYS_JTMS-SWDIO
PA14.Signal=SYS_JTCK-SWCLK
PA2.Signal=USART2_TX
PA3.Signal=USART2_RX
PA9.Signal=USB_OTG_FS_VBUS
PB10.Signal=I2S2_CK
PB12.Signal=I2S2_WS
PC1.Signal=I2S2_SD
PC6.Signal=GPIO_Output
PC7.Signal=GPIO_Output
PC8.Signal=GPIO_Output
PC9.Signal=GPIO_Output
PH0-OSC_IN.Signal=RCC_OSC_IN
PH1-OSC_OUT.Signal=RCC_OSC_OUT
