mpinese/adc/(commit log)

2014-05-04 Initial commit. Power supply mostly done; nothing else.
    [ADC.sch, Buffers.sch, PCM4222EVM.sch, PSU.sch]
2014-05-05 Started on parts selection.
    [Parts list.ods]
2014-05-06 Started work on changing the PSU to fully complementary.
    [ADC.sch, Buffers.sch, PCM4222EVM.sch, PSU.sch]
2014-05-06 Started splitting the PSU into internal and external subsections.
    [ADC.sch, Buffers.sch, PCM4222EVM.sch, PSU-external.sch, PSU-internal.sch, Parts list.ods]
2014-05-07 Simplified external PSU, now that I've decided to put it in its own case.
    [ADC.sch, Buffers.sch, PCM4222EVM.sch, PSU-external.sch, PSU-internal.sch]
2014-05-09 Added an analysis of the low pass filter present in the PCM4222EVM differential input stage.
    [ADC.sch, Buffers.sch, PCM4222EVM.sch, PSU-external.sch, PSU-internal.sch]
2014-05-10 Completed the overall system layout, added clipping and input stages.
    [ADC.sch, Clipper.sch, Input.sch, Line_receiver.sch, PCM4222EVM.sch, PSU-external.sch, PSU-internal.sch]
2014-05-10 Further PSU tweaking for extra safety, added a TODO list.
    [ADC.sch, PSU-external.sch]
2014-05-12 Expanded the internal PSU to include a 4 V supply. Started on reference sharing.
    [ADC.sch, Clipper.sch, Line_receiver.sch, PCM4222EVM.sch, PSU-external.sch, PSU-internal.sch]
2014-05-12 Cleaned up the internal PSU a bit.
    [ADC.sch, Clipper.sch, Line_receiver.sch, PCM4222EVM.sch, PSU-external.sch, PSU-internal.sch]
2014-05-15 Many additions; the system's almost together. Just need to tidy up a few things around the PSU and the input stage.
    [ADC.sch, Clipper.sch, Line_receiver.sch, PCM4222EVM.sch, PSU-external.sch, PSU-internal.sch]
2014-05-21 First complete system. Still a few things to check.
    [ADC.sch, Clipper.sch, Line_receiver.sch, PCM4222EVM.sch, PSU-external.sch, PSU-internal.sch, input_filter_RC1.sch, input_filter_RC2.sch]
2014-05-21 Noise analysis completed; signal section finished.
    [ADC.sch, Clipper.sch, Line_receiver.sch, Noise_analysis.sch]
2014-05-21 V1.0 Schematic Completed.
    [ADC.sch, PSU-internal.sch]
2014-05-21 Added tag Schematic 1.0 for changeset 5b91ce586c58
2014-05-21 Added component numbers.
    [ADC.sch, Clipper.sch, Line_receiver.sch, PSU-external.sch, PSU-internal.sch]
2014-05-21 Removed tag Schematic 1.0
2014-05-21 Added tag 1.0 Schematic for changeset b9613084385d
2014-05-21 Removed tag 1.0 Schematic
2014-05-21 More packages specified; changed the external PSU overvoltage protection devices.
    [PSU-external.sch]
2014-05-21 More packages specified.
    [PSU-external.sch]
2014-05-22 Minor schematic mods, started assigning DigiKey part numbers to components.
    [ADC.sch, BOM.csv, Clipper.sch, Line_receiver.sch, PCM4222EVM.sch, PSU-external.sch, PSU-internal.sch, Sulzer_feedback_cap_esr.sch]
2014-05-22 Added more DigiKey catalogue numbers.
    [Line_receiver.sch]
2014-05-23 Minor changes to noise sim.
    [Noise_analysis.sch]
2014-05-23 Further component specifications for the BOM.
    [ADC.sch, Clipper.sch, Line_receiver.sch, Noise_analysis.sch, PCM4222EVM.sch, PSU-external.sch, PSU-internal.sch]
2014-05-26 More components specified
    [ADC.csv, ADC.sch, BOM.csv, Clipper.sch, Line_receiver.sch, PCM4222EVM.sch, PSU-external.sch, PSU-internal.sch]
2014-05-28 Completed component product code specification; started on footprints.
    [ADC.csv, ADC.sch, Clipper.sch, Line_receiver.sch, PCM4222EVM.sch, PSU-external.sch, PSU-internal.sch]
2014-05-29 Moved to new version of KiCad with updated footprints. Changed most of the footprints to match.
    [ADC.dsn]
2014-05-30 Added internal connectors; specified all footprints and part IDs except for the trafos.
    [ADC.sch]
2014-05-30 More footprint specification and connector additions; almost done.
    [ADC.csv, ADC.kicad_pcb, ADC.sch, Clipper.sch, Line_receiver.sch, PSU-external.sch, PSU-internal.sch]
2014-05-31 Changed from the P0720ECL SIDACtor to the more sensitive P0300.
    [PSU-external.sch]
2014-05-31 Changed to use the fixed IEC socket device; the PSU netlist should now be (more) correct.
    [ADC.csv, ADC.kicad_pcb, ADC.sch, PSU-external.sch, Parts list.ods]
2014-06-01 A lot of routing, some parts changes: * Added snubber C/RC snubbers to transformer secondaries. * Changed PSU OA from OPA209 to OPA27. * Routed external PSU. * Mostly done routing internal circuits. 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
    [ADC.kicad_pcb, ADC.sch, Clipper.sch, Line_receiver.sch, PSU-external.sch, PSU-internal.sch]
2014-06-02 First complete version. * Added 10uF decoupling capacitors to the start of each signal processing section. * Completed routing. A few -18 V nets remain unrouted; these will be wired in.
    [ADC.kicad_pcb, ADC.sch, Line_receiver.sch, PSU-internal.sch]
2014-06-03 Routed the -18 V line, added licence and descriptive text.
    [ADC.kicad_pcb]
2014-06-03 Started work on a print SVG of the board layout.
2014-06-04 Added vias for ground-connected pins that cannot be soldered from the top, as I can't make PTHs. Rearranged the power inputs slightly.
    [ADC.kicad_pcb, PSU-internal.sch]
2014-06-04 Filled in the ground plane this time -- oops!
    [ADC.kicad_pcb]
2014-06-04 Minor ground rerouting.
    [ADC.kicad_pcb]
2014-06-06 Collected layouts into a transparency svg. Created board and schematic BOMs (these still need to be fused)
    [BOM_board.csv, BOM_sch.csv]
2014-06-08 Moved component designators on silkscreen so that they are not covered by components. Combined silkscreen and user top layers into a cover layer for printing.
    [ADC.kicad_pcb]
2014-06-09 Created script to collate final BOM.
    [BOM_board.csv, BOM_combined.csv, BOM_final.csv, BOM_sch.csv]
2020-09-04 Update to 2020!
    [14A-30-515--3DModel-STEP-1.STEP, ADC.dsn, ADC.kicad_pcb, ADC.sch, BOM_combined.csv, BOM_final.csv, Buffers.sch, CUI_DEVICES_UJ2-BH-1-TH.step]
2020-09-11 Schematic bugfixes
    [bom.xlsx, bom_extra.csv, usb_bridge.kicad_pcb, usb_bridge.sch]
2020-09-15 Switched to left-justified audio input
2020-09-18 Added I2S test signal generator circuit.
    [i2s_test_generator_qucsstudio.sch, test_i2s_gen.kicad_pcb, test_i2s_gen.sch]
2020-09-18 Added preregs to all rails.
    [transformer_board.kicad_pcb, transformer_board.sch]
2020-09-21 Started changing test generator to CPLD design
    [test_i2s_gen.kicad_pcb, test_i2s_gen.sch]
2020-09-21 Added TODO to enclosure SVG
2020-09-21 Restored serial audio test generator discrete design from #cee2e1e
    [test_i2s_gen.kicad_pcb, test_i2s_gen.sch]
2020-09-29 Fixed error in silkscreen
    [transformer_board.kicad_pcb, transformer_board.sch]
2020-10-01 Tweaks to USB code, works on linux but not Windows (suspect driver issue)
    [I2S to USB FS bridge.ioc, i2s_to_usb_controller.c, main.c, test.py]
2020-10-01 I2S test generator refinements
    [test_i2s_gen.kicad_pcb, test_i2s_gen.sch]
2020-10-02 Fixed bug in overrun detection code. Fixed bug due to error in HAL_I2S_Receive docs (size to read is in 32-bit words, not 16-bit as given in the docs). Reduced i2s buffer size for testing. Added some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
    [i2s_to_usb_controller.c, i2s_to_usb_controller.h, main.c]
2020-10-03 First rough working version. Sync issues on i2s.
    [i2s_to_usb_controller.c, main.c]
2020-10-03 Got DMA half working. Dependence on MAX_USB_XFERSIZE noted.
2020-10-10 Now have successful streaming acquisition (single-channel only). Halt & restart still broken.
    [I2S to USB FS bridge.ioc, i2s_to_usb_controller.c, i2s_to_usb_controller.h, main.c]
2020-10-12 I2S sync issues, not yet resolved
    [I2S to USB FS bridge.ioc, i2s_to_usb_controller.c, main.c]
