mpinese/adc/(notices)

Notices in the files:
firmware/I2S to USB FS bridge/Core/Src/main.c:
© Copyright (c) 2020 STMicroelectronics.
All rights reserved.
This software component is licensed by ST under Ultimate Liberty license
(C) COPYRIGHT STMicroelectronics *****END OF FILE
kicad/usb_bridge/usb_bridge.kicad_pcb:
Reuse permitted under CC-BY 4.0
kicad/usb_bridge/test_i2s_gen_cpld/test_i2s_gen.sch:
Licenced for reuse under CC-BY 4.0
kicad/usb_bridge/test_i2s_gen_discrete/test_i2s_gen.kicad_pcb:
Licence: CC-BY 4.0
kicad/transformer_board/transformer_board.kicad_pcb:
Made available for reuse under the CC BY 4.0 Licence
under CC BY 4.0
kicad/signal_board/signal_board.kicad_pcb:
Licensed for reuse under CC BY 4.0
